sdcastanedaa-max/Control-Automation/docs/figures/DS18B20_TemperatureSensor.jpg

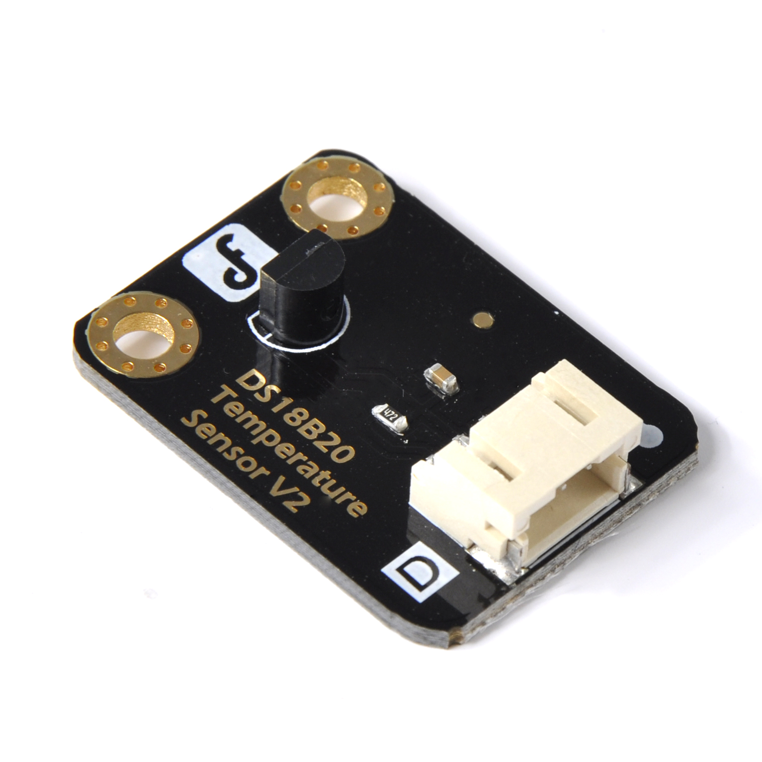
docs/figures/DS18B20_TemperatureSensor.jpg
