sdcastanedaa-max/Control-Automation/docs/figures/HF3FD_Relay.jpg

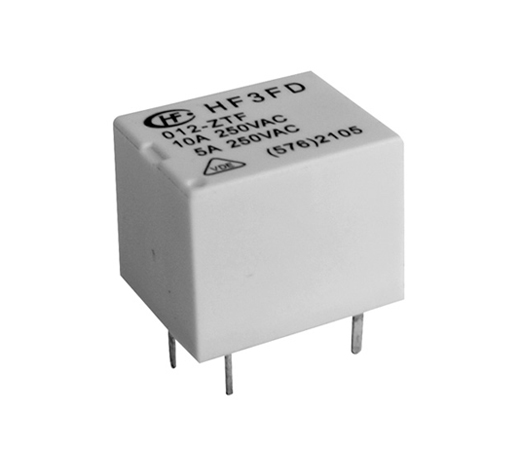
docs/figures/HF3FD_Relay.jpg
