sdcastanedaa-max/Control-Automation/history/Nov20/index.html

# Hair Dryer Assistant

Location (City or Coordinates)

Hair Thickness ⓘ

Feel an individual strand:

Fine = hard to see and feel

Medium = visible but not coarse

Thick = strong and sturdy

Hair Porosity ⓘ

Drop a strand in water—wait 3–5 minutes:

Low = floats, repels water, dries slow

Normal = sinks slowly

High = sinks fast, dries fast, may frizz

Generate Recommendations

## Environment Conditions

Temperature --

Humidity --

Drying Power Index --

Environment Type --

## Drying Protocol

Towel-Dry Phase: ⓘ --

Method Gently squeeze and pat with towel

Duration --

Reduces blow-dry time by --

Visual Progress Guide:

🚫 Dripping or pooling: Too wet (0-30%)

💧 Towel heavy, hair saturated: ~40%

🤏 Towel less damp, drips stop: ~60-70%

✓ Hair moist, lifts easily, ready to dry: ~80%

Thorough towel drying reduces heat exposure and minimizes damage to hair structure. Use microfiber or cotton towels and pat gently—never rub vigorously.

Air Dry Phase (room temperature): ⓘ --

Temperature Room temperature

No heat required Reduces heat damage

Bulk Phase (-- heat to ~90% dry): ⓘ --

Temperature Range --

Distance from Hair --

Finish Phase (Medium/Low heat to ~10%): ⓘ --

Temperature Range --

Distance from Hair --

Estimated Total Time --

## Energy Cost

Electricity Price --

Hair Dryer Power --

Total Energy Used --

Estimated Cost --

Auto-detected for your location

## Cost Analysis by Priority & Towel-Dry Level
