sdcastanedaa-max/Control-Automation/ACEE_HardwareSchematic.pdf

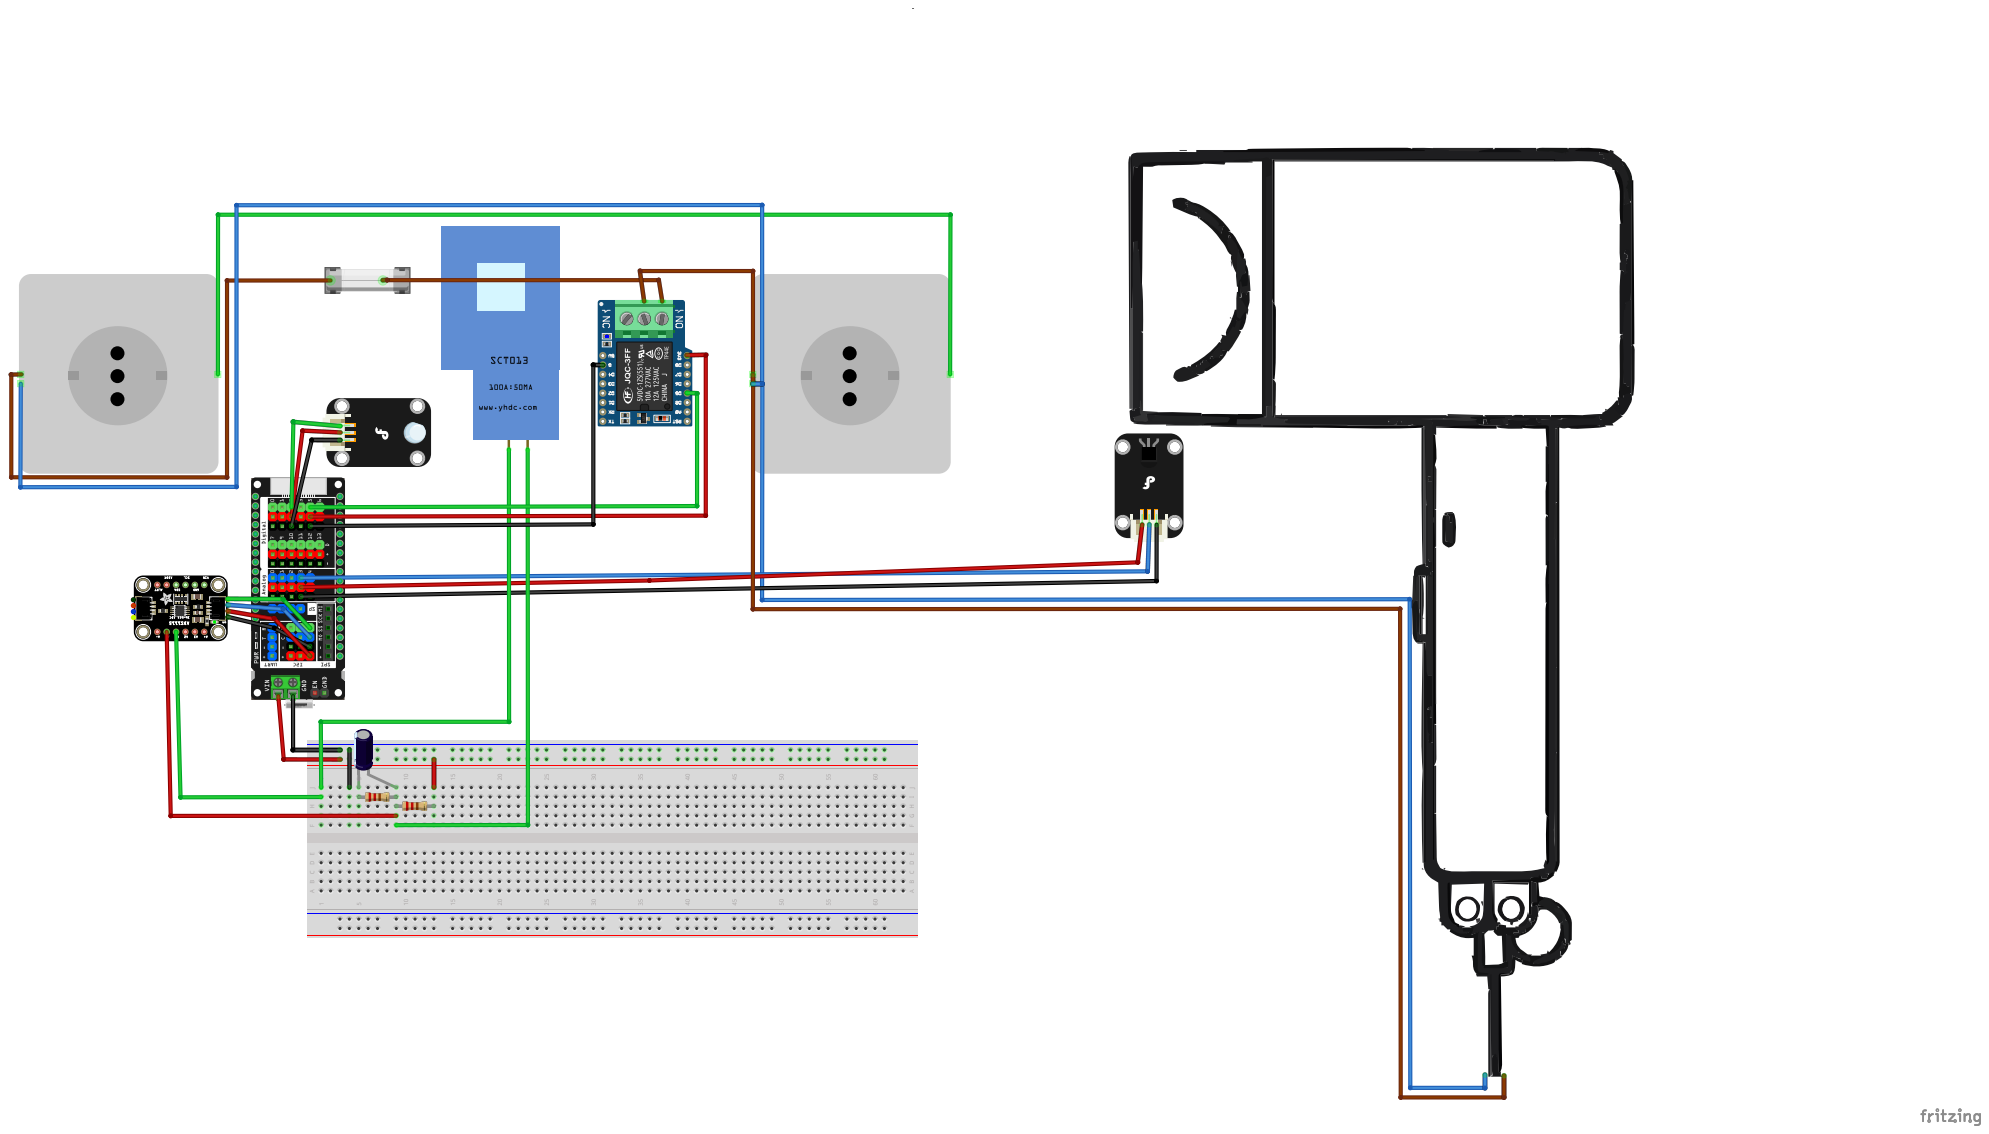
[picture p25: page 1]
