sdcastanedaa-max/Control-Automation/docs/figures/Actuation_LED_Relay_Schematic.pdf

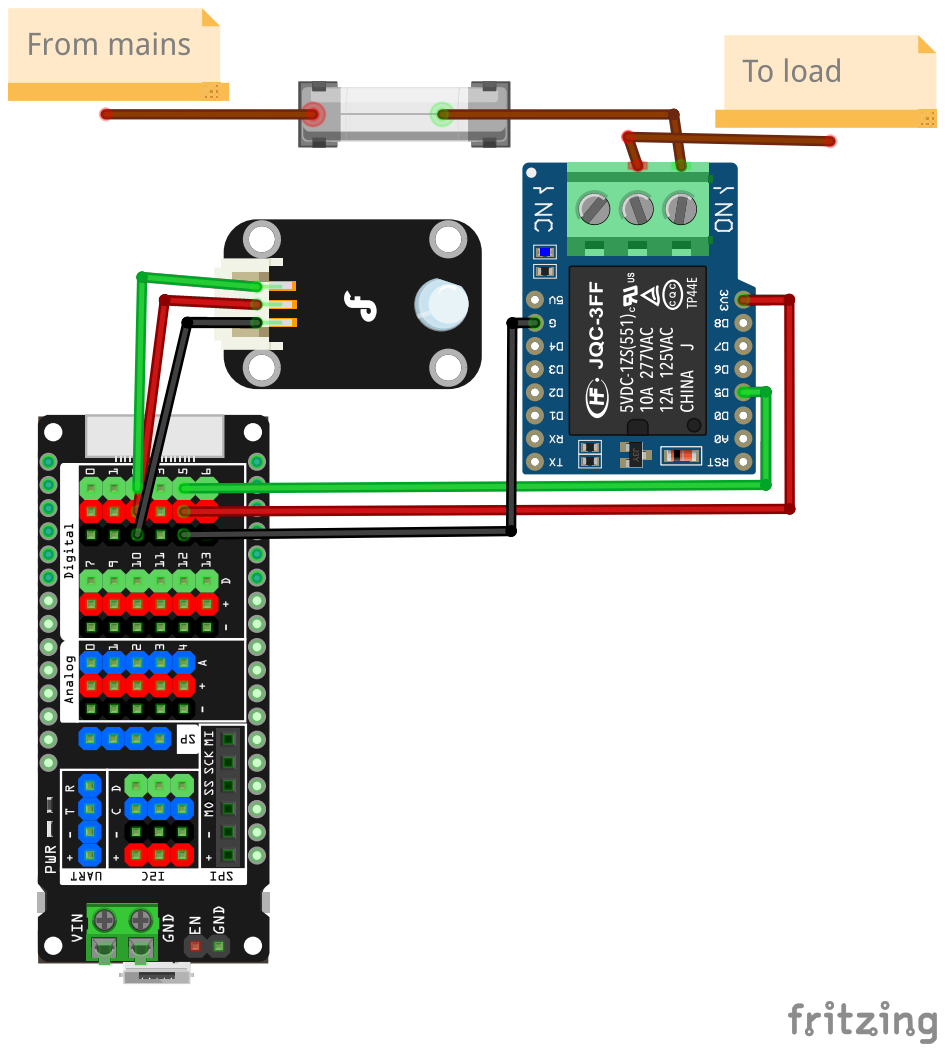
[picture p26: page 1]
