sdcastanedaa-max/Control-Automation/docs/figures/LM35_TemperatureChain_Schematic.pdf

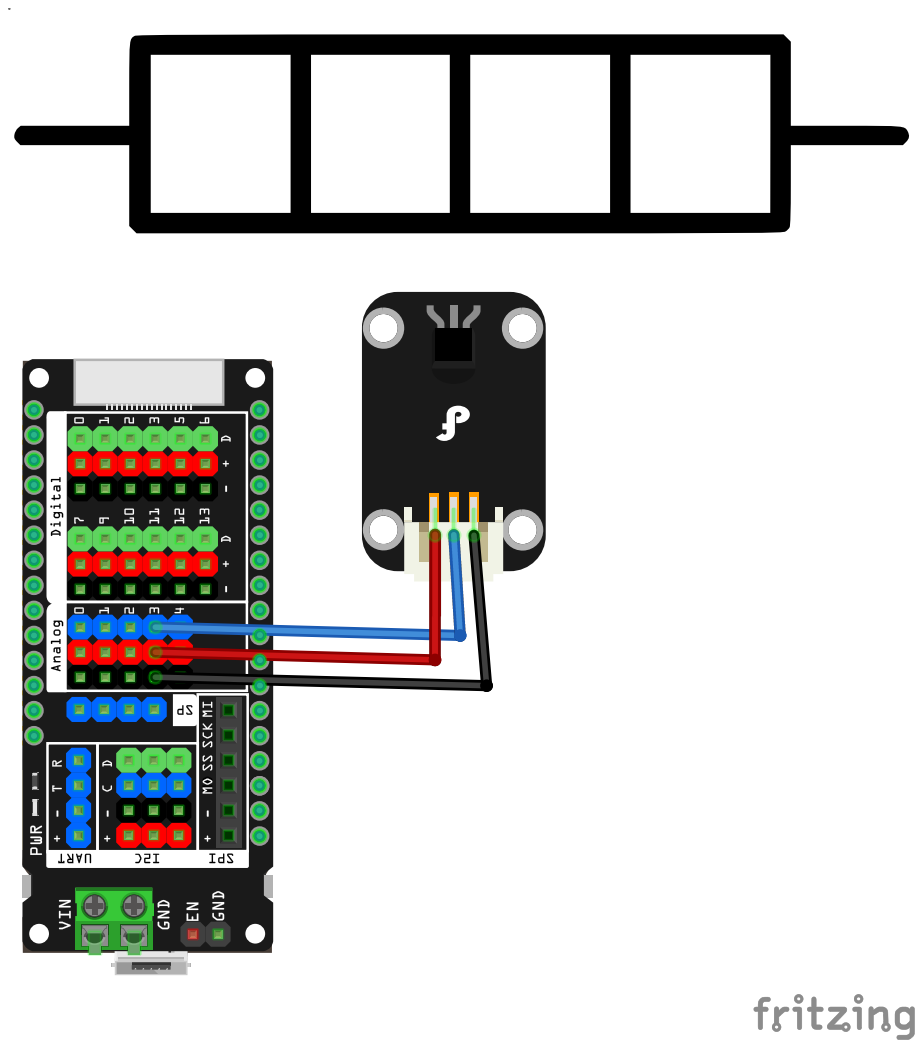
[picture p27: page 1]
