sdcastanedaa-max/Control-Automation/docs/figures/ACEE_HardwareSchematic.pdf

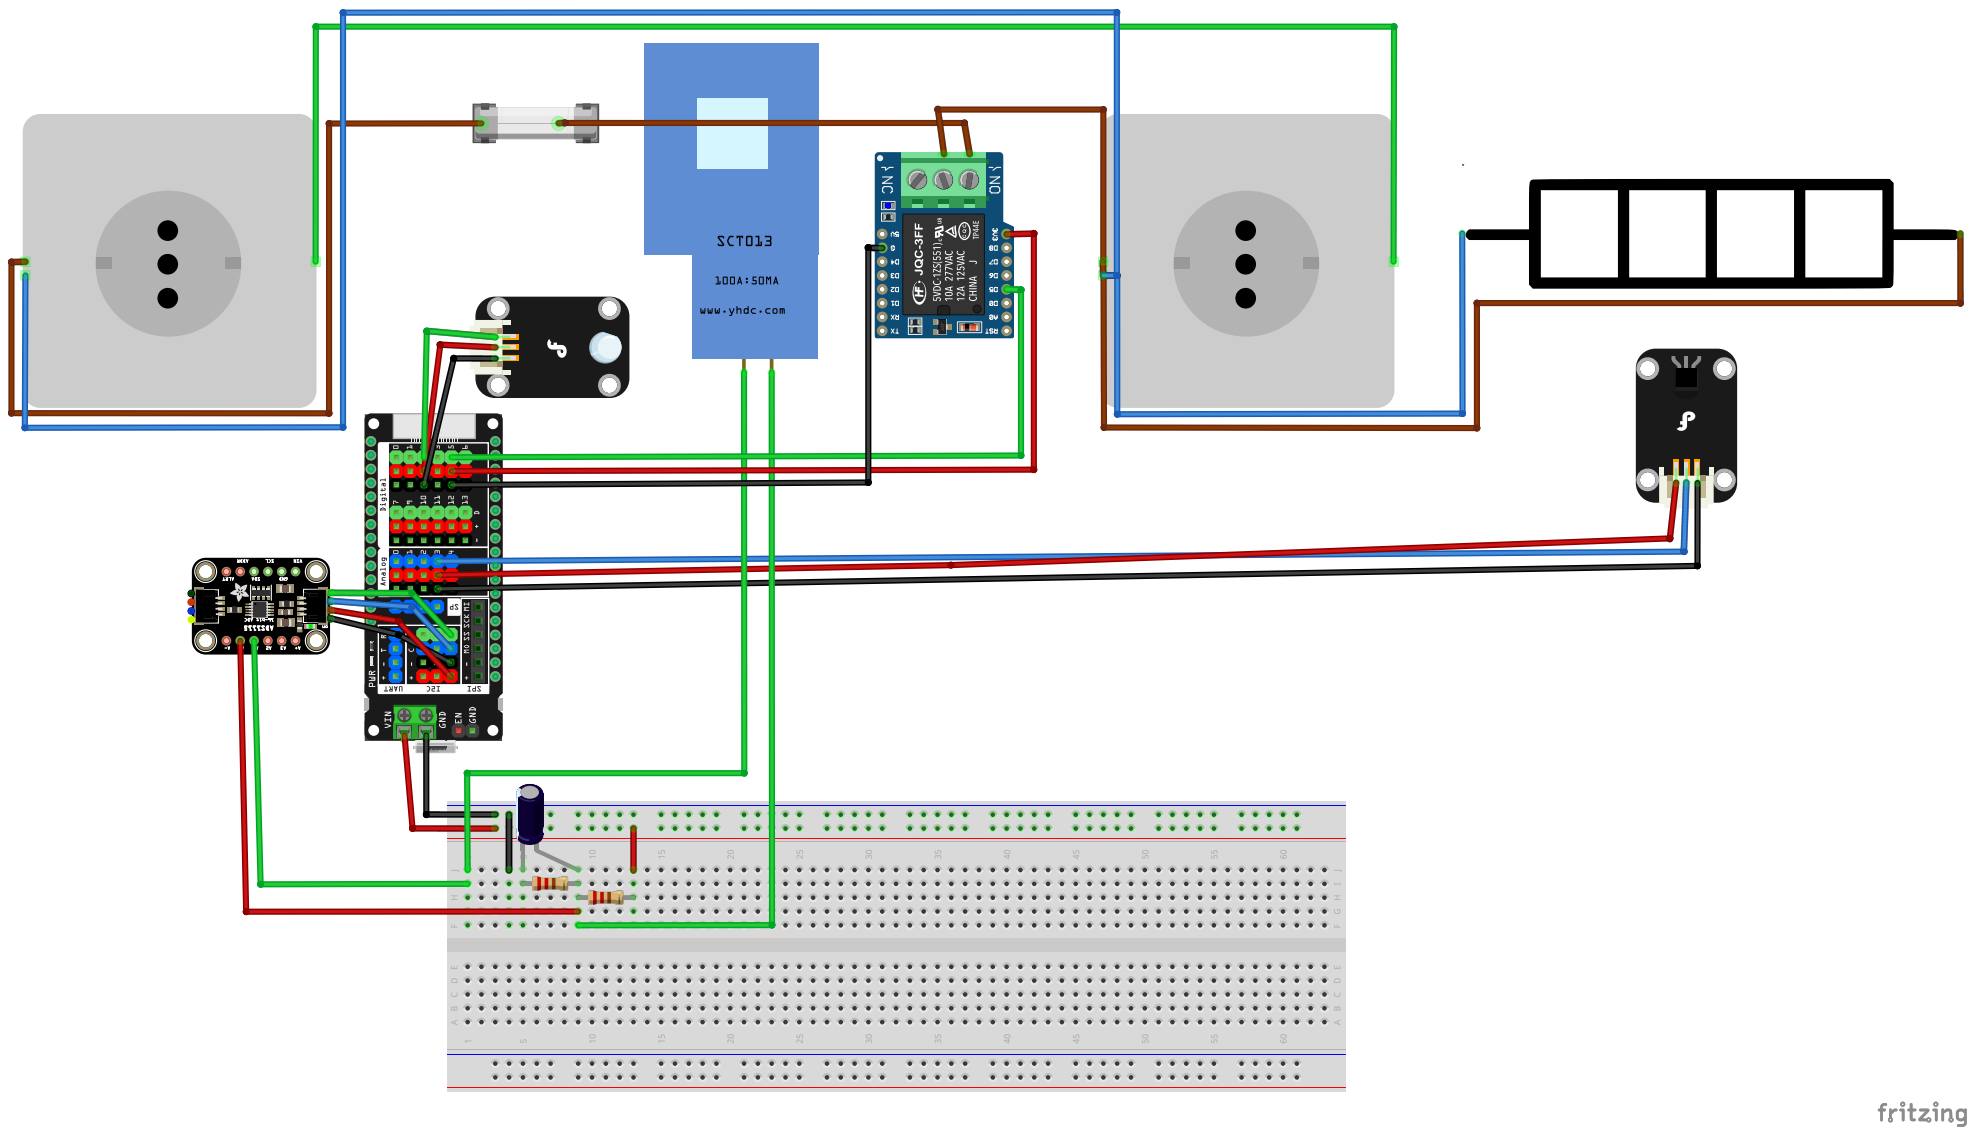
[picture p28: page 1]
