sdcastanedaa-max/Control-Automation/(commit log)

2025-09-18 feat: add Arduino/ESP32 development environment
    - Add PlatformIO configuration for Arduino Uno and ESP32
    - Include basic LED blink example in src/main.cpp
    - Update .gitignore for PlatformIO artifacts
    - Set up conda environment 'arduino' with PlatformIO and esptool
2025-10-02 docs: add PlatformIO usage instructions for Arduino Uno and ESP32
2025-10-02 chore(pio): set esp32dev as default env and configure port /dev/cu.usbserial-110 for Mac M1
2025-10-02 refactor: rename main.cpp to test.cpp and update LED blink code
    - Rename src/main.cpp to src/test.cpp
    - Use LED_BUILTIN with safe fallbacks for ESP32/Arduino
    - Set correct serial baud per board (115200 for ESP32, 9600 for Uno)
    - Change off delay to 2000ms for asymmetric blink pattern
    - Update README with detailed PlatformIO usage instructions
2025-10-09 Add SCT013_30A_esp32_STUDENT Arduino sketch
2025-10-09 Add initial implementation of setup and loop functions for current sensor
2025-10-09 Fix RMS calculation logic: correct filter, time-weighted integration, and proper reset sequence
    [SCT013_30A_esp32_STUDENT.ino]
2025-10-17 Fix RMS calculation and improve current sensor implementation
    Key Changes:
    1. Removed debug_time variable - simplified timing control
    2. Fixed voltage reading: v_sensor = read_voltage() - v_calib (auto-calibration)
    3. Fixed current calculation: current = 30.0 * v_sensor (removed double subtraction)
    4. Fixed RMS calculation: rms_current = sqrt(quadratic_sum_current * freq) instead of sqrt(quadratic_sum_v / quadratic_sum_counter)
    5. Renamed variables for clarity: quadratic_sum_rms -> rms_current
    6. Removed complex debug output - back to simple Serial.println(accumulated_current)
    7. Fixed variable name: quadratic_sum_v -> quadratic_sum_current in accumulation
    Previous Issues Fixed:
    - Double vo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
2025-10-17 Remove Arduino .ino folder - switching to ESP32 implementation
    - Deleted SCT013_30A_esp32_STUDENT/ folder containing Arduino .ino files
    - Moving forward with ESP32 implementation in src/main.cpp
    - Arduino sketch was for Arduino Uno, ESP32 version is more suitable for this project
    - Cleaner project structure with PlatformIO-based ESP32 development
2025-10-17 Update README with current sensor project documentation
    - Replaced verbose conversation history with concise project documentation
    - Added hardware setup details (ESP32, SCT013, ADS1115)
    - Documented serial monitoring issues and solutions
    - Included technical implementation fixes (RMS calculation, calibration)
    - Added usage instructions and troubleshooting guide
    - Current status: ESP32 working, ADS1115 I2C working, current sensor detecting real current
    - Serial output shows clean first line, occasional garbage thereafter
2025-10-17 Correct README: Monitor script NOT working yet
    - Updated monitor script status to accurately reflect it's NOT working
    - Added clear indication that garbage characters still persist after first line
    - Updated current status section with ❌ for monitor script
    - Added note that monitor script still needs debugging
    The serial monitoring issue remains unresolved despite our troubleshooting attempts.
2025-10-23 Fix compilation errors and improve averaging calculation
    Changes since 577246b:
    - Add missing Arduino.h include for Serial support
    - Add missing variable declarations (quadratic_sum_current, rms_current)
    - Fix averaging calculation: use actual accumulated_counter instead of fixed sampleAverage
    - Reorder reset operations: reset accumulated_current before accumulated_counter
    - Simplify README.md from verbose setup instructions to concise project overview
    This fixes compilation issues that were preventing the code from building and improves the accuracy of current measurements.
2025-10-23 Working current sensor code
2025-10-23 Addition of relay always HIGH
2025-11-13 Fix serial port script syntax and update baud rate
    [Nov13.py]
2025-11-13 Fix Nov13.ino syntax errors and update Nov13.py to send relay commands
    [Nov13.ino, Nov13.py]
2025-11-20 Add hair dryer assistant with cost analysis by priority
    - Fetch weather data from Open-Meteo API based on location
    - Auto-detect electricity prices by region/country
    - Calculate hair dryer recommendations across 11 priority levels (0-100%)
    - Display cost vs priority tradeoff in interactive bar chart
    - Allow users to click bars to view detailed settings for each priority
    - Show drying time, heat settings, airflow, and energy cost estimates
    - Recommend lowest-cost option while allowing user exploration
    Amp-Thread-ID: https://ampcode.com/threads/T-16cb5f47-b066-4238-8e6a-288f8c28cfa0
2025-11-20 Restructure results layout: Environment → Protocol with embedded settings → Cost analysis
    - Reorganize results sections for better information flow
    - Embed protocol phases (Air Dry, Bulk, Finish) as main display items
    - Move detailed settings (heat, temperature, distance) into expandable info panels per phase
    - Show heat setting inline in phase labels for quick reference
    - Display Air Dry phase as greyed-out when not recommended, with reasons
    - Remove redundant Drying Recommendation and Recommended Settings sections
    - Keep Cost Analysis chart at end for comparison
2025-11-20 Add spacing fix, update energy calculation for variable power, add inline info buttons for Hair Thickness and Porosity
2025-11-20 Use lower heat for finish phase
2025-11-27 Use analog readings for temperature sensor instead of I2C
    - Change read_temperature() to use analogRead(TEMP_SENSOR_PIN) directly
    - Remove I2C configuration calls for temperature (config_i2c_temp, config_i2c_current)
    - Remove unnecessary I2C delays and serial debug output
    - Simplify temperature calculation: voltage = rawValue * (3.3/4095), temp = voltage * 100
    - Temperature and current now send continuously via serial without manual intervention
2025-11-27 Streamlit Dashboard
    [export_MarginalPriceDayAheadMarket_2025-11-27_16_23.csv]
2025-11-27 Optimize styles.css for tighter, unified dashboard design
    - Reduce padding/margins: 20px → 12px for body, cards, sections
    - Tighten spacing between elements (rows, cards, form groups)
    - Update chart height 400px → 350px
    - Apply primary teal color to headings (h1, h2, titles)
    - Replace button gradient with consistent color variables
    - Add uppercase styling to section headers and badges
    - Harmonize info/warning backgrounds with unified opacity
    - Reduce font sizes on labels, inputs, and details (14px → 13px)
    - Improve shadows for cleaner, subtler appearance
    - Add letter-spacing to headings/badges for polish
    Amp-Thread-ID: https://ampcode.com/threads/T-0357d763-46bc-4831-8aef-95c390ad167d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
2025-11-27 Refactor Hair Dryer Assistant to Streamlit with full Nov20 UI matching
    Major changes:
    - Converted Python Streamlit app to match HTML/JS version from Nov20
    - Added external CSS styling (styles.css) with 450+ lines
    - Implemented proper card-based layout with 800px max-width
    - Added all sections in Streamlit containers with borders
    - Implemented interactive selection controls for priority and towel-dry levels
    - Added air-drying recommendation logic (hybrid drying)
    - Improved visual prominence of total drying time
    - All phases (towel-dry, air-dry, bulk, finish) always visible with expandable details
    - Energy cost calculation with location-based electricity pricing
    - Interactive cost analysis cha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
    [export_MarginalPriceDayAheadMarket_2025-11-27_16_23.csv]
2025-11-27 Optimize dashboard UI: unified 12px font sizing, inline info buttons with labels, reduced spacing, improved color palette
    Amp-Thread-ID: https://ampcode.com/threads/T-7581de5c-a6e9-4077-aed6-dd540e176462
2025-11-27 Redesign dashboard with minimal neo-classical layout and inline title inputs
    - Moved all inputs (location, thickness, porosity, generate) to title row
    - Implemented minimal bottom-border input style for clean, aligned design
    - Reduced chart height from 400px to 280px
    - Compressed vertical spacing throughout (top padding 12px→4px, sections 12px→8px)
    - Increased max-width to 1200px for better horizontal layout
    - Replaced card-based sections with line separators
    - All text baselines now align perfectly in title row
    - Labels styled at 11px with secondary color for visual hierarchy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
    [StreamlitDashboard.py]
2025-11-27 Fix cost calculation matching, index alignment, and UI cleanup
    - Added REE API integration for real-time Spanish electricity prices
    - Fixed cost calculation to use actual electricity price instead of hardcoded 0.26
    - Fixed index mismatch: towel_idx * num_priorities + priority_idx
    - Removed empty section divs that were creating blank space
    - Override Streamlit container styling (.st-ba, .st-b7) for minimal input design
    - Total Drying Time label now uses normal text color
    - Remove top padding from stMainBlockContainer at all screen widths
    Amp-Thread-ID: https://ampcode.com/threads/T-1569d142-68d5-4b07-a623-43b854e9ba50
    [StreamlitDashboard.py]
2025-11-27 Remove info button from hair inputs and How to use section; update footer with electricity API sources
2025-11-29 Clean up old project files and add new API implementation files
    Amp-Thread-ID: https://ampcode.com/threads/T-10a0d4d8-47e9-4f4f-ae6c-c8ee1325e955
2025-11-29 Implement safety strategy with DEMO_MODE and improved sensor integration
    Integrated_Project.py changes:
    - Added DEMO_MODE constant (default=1): divides protocol durations by 10 for testing
    - Added apply_demo_mode() function to scale protocol durations
    - Refactored fetch_protocol() to always apply DEMO_MODE before returning
    - Enhanced SerialBoard class:
    * Added latest_temp and latest_current tracking
    * Improved connect() with Arduino handshake verification (PING/PONG)
    * Updated read_sensor_data() to parse Arduino format: 'Temperature: XX.XX | Current: X.XXXXX'
    * Better error handling and resource cleanup
    - Completely refactored main() function:
    * User input: location (default: Barce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
    [Integrated_Project.py, StreamlitDashboard.py]
2025-12-03 feat: add cross-platform public API deployment with ngrok and multi-service runner
    - Add ngrok support for public API and dashboard URLs
    - Update mock_protocol_api.py: fix module imports, disable reload mode
    - Update Integrated_Project.py: support API_URL environment variable
    - Create tmux-based runner for macOS (run.sh) with multi-window support
    - Create batch file runners for Windows (run.bat, run_api.bat, run_dashboard.bat, run_integrated.bat)
    - Create individual service scripts (run_api.sh, run_dashboard.sh, run_integrated.sh)
    - Display dashboard URL at startup for both local and public modes
    - Services can run independently or together via orchestrator scripts
    [Integrated_Project.py]
2025-12-04 Fix hardware/simulation mode sync and serial connection reliability
    [Integrated_Project.py, StreamlitDashboard.py]
2025-12-15 Previous week changes to temperature and current thresholds
2026-01-06 Added Hardware Schematic
2026-01-07 Adjust diagram spacing: increase distance between Main Control and Safety Strategy nodes, move LM35 left and SCT013 right
    Amp-Thread-ID: https://ampcode.com/threads/T-019b9828-6145-70cb-bc29-70ecfa20ce71
2026-01-12 Convert Calibration Iterations section to longtable for page-spanning support
2026-01-12 Add line breaks between Before/After/Reason in Calibration Iterations table
